manweile/BTFM/README.md

# BTFM
Bluetooth to FM Transmitter  
For audio streaming from Android mobile to FM radio
