manweile/BTFM/Sketch1/Images/Airspy_settings.png

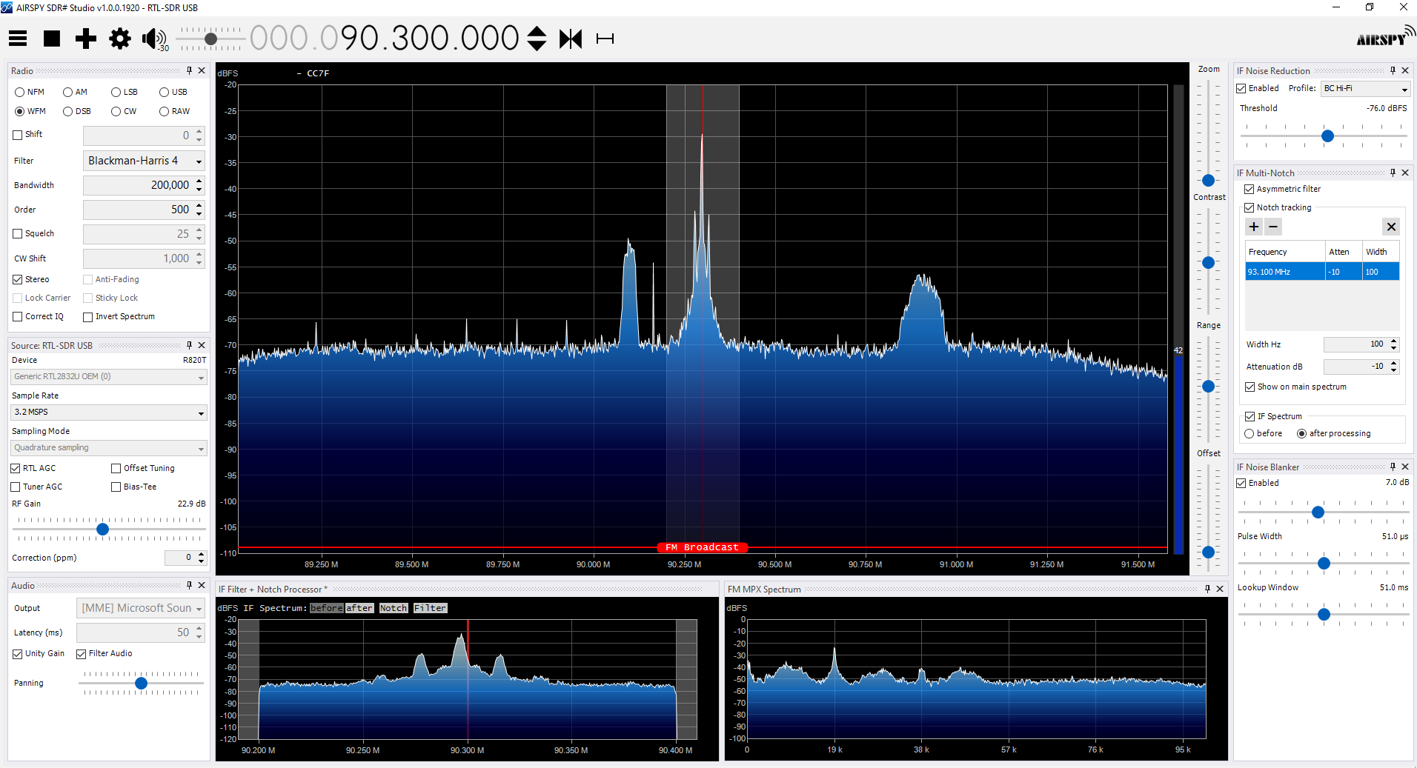
Sketch1/Images/Airspy_settings.png
