manweile/BTFM/Sketch1/Fritzing/program_debug_bb.pdf

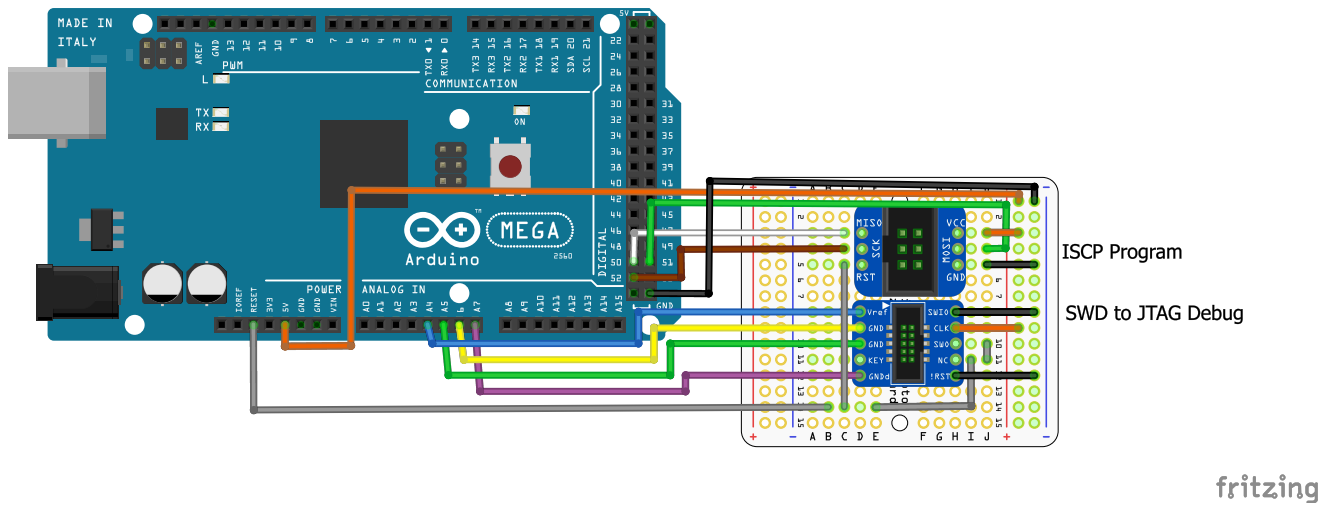
[picture p42: page 1]
