manweile/BTFM/Sketch1/Schematics/program_debug_schem.pdf

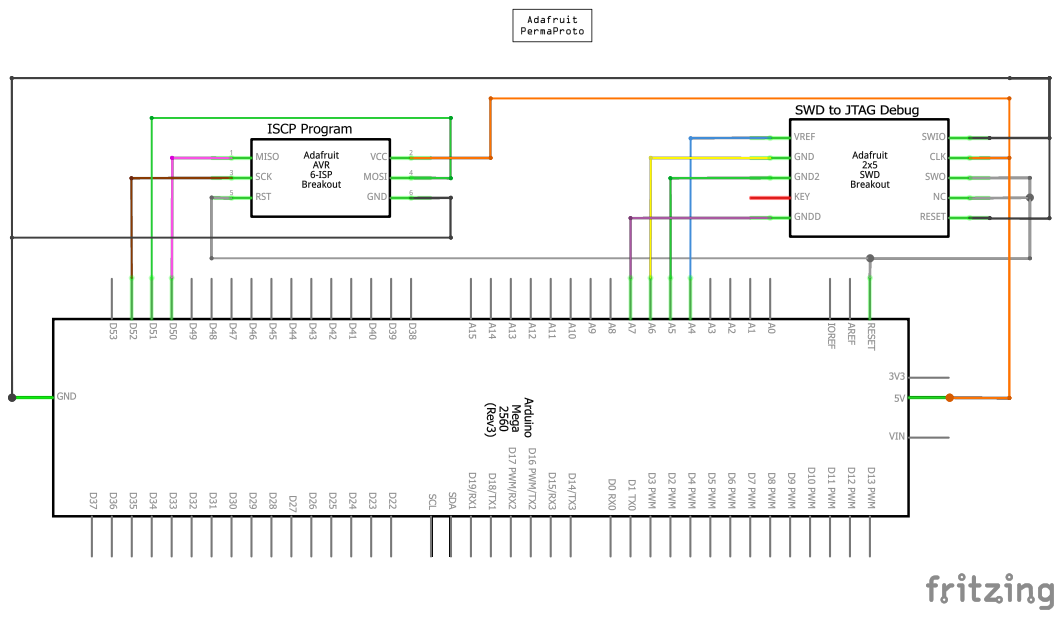
[picture p43: page 1]
