manweile/BTFM/Sketch1/Schematics/attenuator_schem.pdf

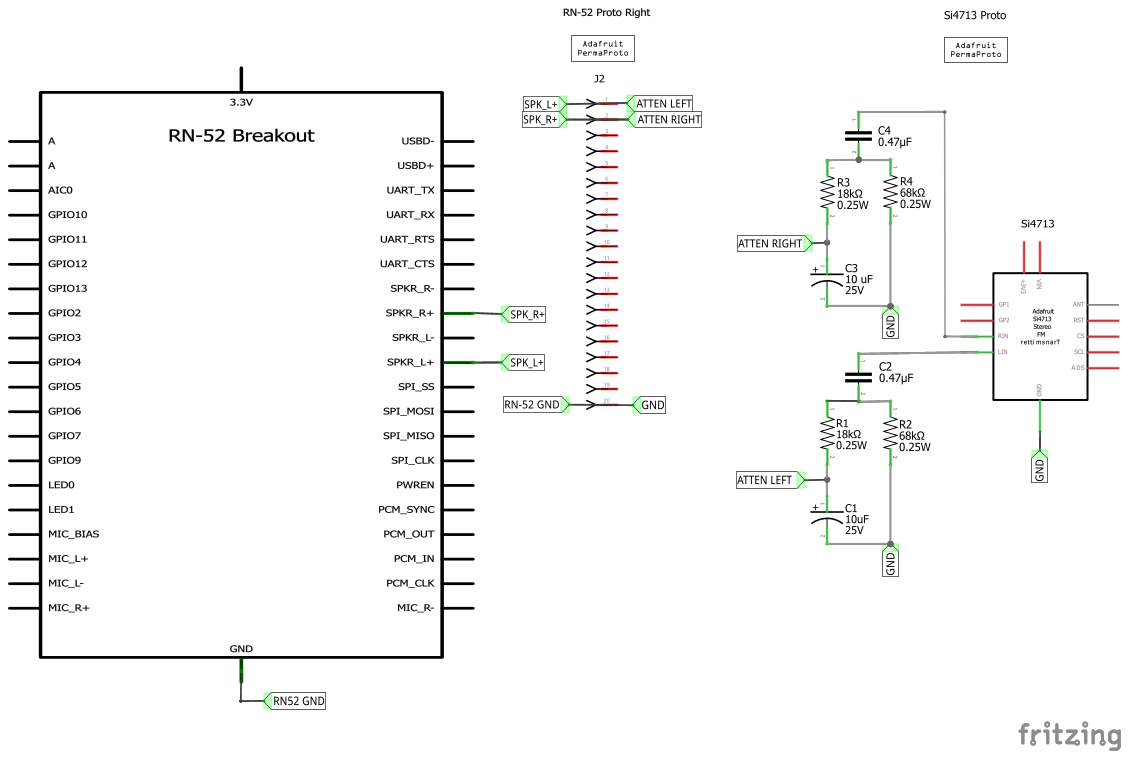
[picture p44: page 1]
