manweile/BTFM/Sketch1/Schematics/dfu_update_schem.pdf

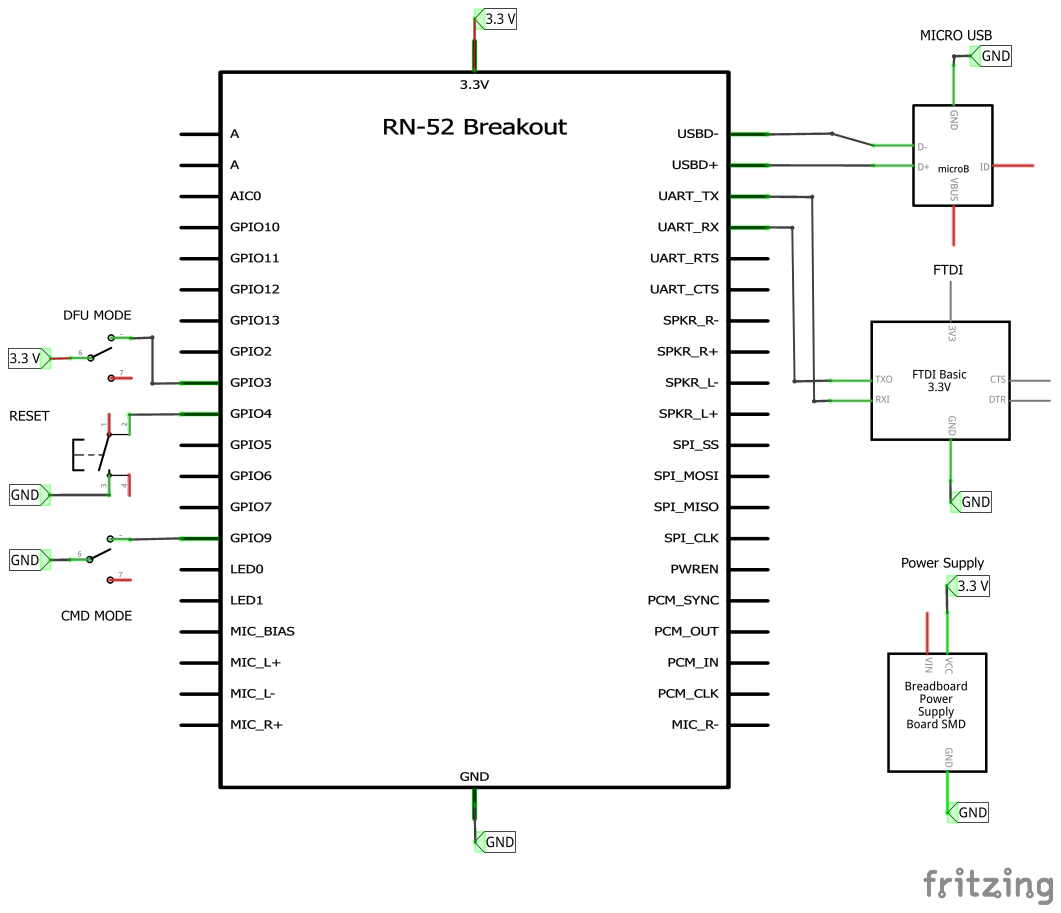
[picture p45: page 1]
