manweile/BTFM/Sketch1/Fritzing/attenuator_bb.pdf

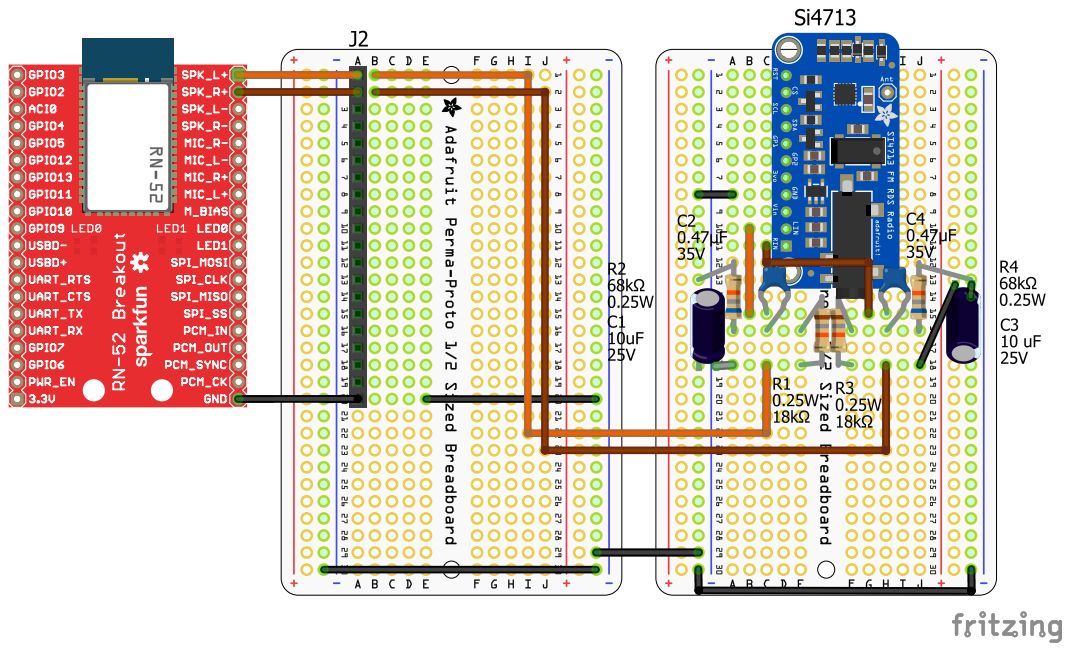
[picture p46: page 1]
