manweile/BTFM/Sketch1/Fritzing/dfu_update_bb.pdf

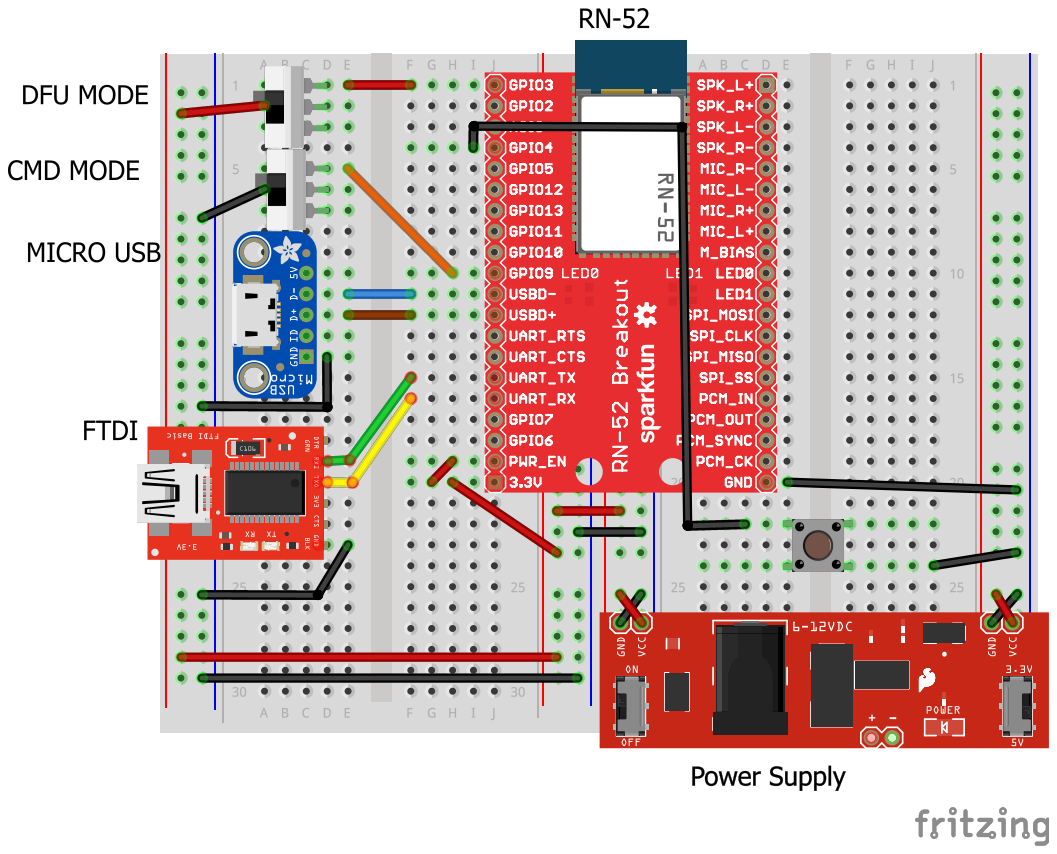
[picture p47: page 1]
