manweile/BTFM/(list of files, drawings)

Other design files:
Sketch1/Fritzing/attenuator.fzz
Sketch1/Fritzing/btfm.fzz
Sketch1/Fritzing/dfu_update.fzz
Sketch1/Fritzing/program_debug.fzz
Sketch1/Fritzing/sim_attenuator.fzz
