manweile/BTFM/(commit log)

2024-03-27 move schematics
2024-04-03 update schamatics and fritzing for level shifter
    [btfm.fzz]
2024-04-03 added schematic pdf
2024-04-03 update properly for schematic
2024-04-21 fritzing update
    [btfm.fzz]
2024-05-05 minor udpate
    [btfm.fzz]
2024-11-10 Fritzing updates
    [attenuator.fzz, btfm.fzz, dfu_update.fzz, program_debug.fzz, sim_attenuator.fzz]
2024-11-15 update fritzing
    [attenuator.fzz, btfm.fzz, dfu_update.fzz, program_debug.fzz]
2024-11-15 image, pdf, fritzing updatges
    [btfm.fzz, dfu_update.fzz]
2024-11-19 more readme updating
    [btfm.fzz, program_debug.fzz]
2024-11-26 dfu fritzing update
    [btfm.fzz, dfu_update.fzz]
2024-11-29 dfu fritzing updates
    [btfm.fzz, dfu_update.fzz]
2024-12-01 fix fritzing errors
    [dfu_update.fzz]
2024-12-09 Update BOM first column width
